bontango/BallyFa/variants/hw1_cyclone_10/variant_pkg.vhd

-- variant_pkg.vhd - was dieses Board ist, als VHDL-Konstante.
-- Variante: hw1_cyclone_10 (BallyFA HW 1.x mit dem Cyclone 10 Board (10CL006YE144C8G))
--
-- Diese Datei liegt im Variantenordner, nicht in rtl/common/, und ist der ERSTE
-- Eintrag der erzeugten .qsf. Alles uebrige am Design ist gemeinsam.
library ieee;
use ieee.std_logic_1164.all;

package variant_pkg is
	-- Ziffer des FPGA-Boards in der Boot-Anzeige ([HW] BOARD_ID . SW_SUB1 SW_SUB2,
	-- siehe rtl/common/version_pkg.vhd): 1 Cyclone II, 2 Cyclone IV, 3 Cyclone IV v4.x, 4 Cyclone 10.
	-- Dieselbe Ziffer steht im Releasenamen BallyFA_4xx.jic.
	constant BOARD_ID : std_logic_vector(3 downto 0) := x"4";

	-- Game ROMs from the configuration flash when no SD card answers (rtl/common/Flash_ROM.vhd).
	constant HAS_FLASH_ROM : boolean := true;
end package variant_pkg;
