bontango/BallyFa/(commit log)

2021-12-23 Update pia6821.vhd
    fixed bug in IRQA(B) flag reset
    [pia6821.vhd]
2026-10-21 BallyFA: gemeinsamer Sourcebaum fuer alle 8 Varianten
    Acht flache Quartus-Ordner (4 FPGA-Boards x Basisplatine HW 1.x/2.x), keiner
    unter Git, zu einem Baum zusammengelegt. Die Historie beginnt hier; die alten
    Ordner liegen als Backup daneben und als ZIP unter ..\Archive\.
    - top/Bally_core.vhd: gemeinsamer Kern, Eingaenge in HW-1.x-Polaritaet
    - top/BallyFA_HW1.vhd / BallyFA_HW2.vhd: Platinenhuellen; HW2 invertiert die
    sechs 4049-Eingaenge und enthaelt lisy_api (USB)
    - rtl/common, rtl/cyclone_{ii,iv,10}, rom/elektra.hex (init_file jetzt explizit)
    - variants/<n>: pins/device/variant_pkg, .qsf generiert von scripts/gen_qsf.ps1
    - scripts: check/build/release mit Quartus 13.0sp1 (Cyclone II) bz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
2026-10-21 Bally.sdc: Hold-Verstoss clk_50 -> clk_out behoben (Cyclone II)
    Cyclone II verletzte Hold auf clk_out (Slow -1.665/-1.829 ns, Fast -0.977 ns,
    Removal -0.068 ns; Critical Warning 332148). clk_out ist ein Ripple-Takt aus
    cpu_clk_gen, dessen Taktbaum ~2.6 ns hinter clk_50 liegt. Alle verletzten
    Pfade gehen clk_50 -> clk_out (RAM/ROM -> cpu68, DIP-Anzeige -> boot_message,
    cpu_reset_h -> Reset); an der mit clk_out zusammenfallenden clk_50-Flanke
    aendern sich deren Daten nicht.
    - set_multicycle_path -hold -start 1 clk_50 -> clk_out (Hold -20 ns, Setup 20 ns)
    - clk_out mit -edges {1 103 203} statt -divide_by 100: der Zaehler teilt
    durch 101 (51 high / 50 low), die fallende Flanke lag 10 ns daneb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
2026-10-21 Kern mit HW_GEN, vier Platinenhuellen, FLASH-Pins (Vorbereitung x.30)
    Die Unterschiede HW 1.x / HW 2.x (4049-Inversion, lisy_api, LED_1/LED_2)
    liegen jetzt im Kern (Generic HW_GEN, paarweise generate). Die Huellen
    deklarieren nur noch Ports:
    BallyFA_HW1 / BallyFA_HW2 Cyclone IV/10, mit FLASH_DCLK/NCS/ASDO/DATA0
    BallyFA_HW1_cii / BallyFA_HW2_cii Cyclone II, ohne (keine User-I/O dafuer)
    Generic HAS_FLASH_ROM (variant_pkg) ist ueberall noch false, die Flash-Pins
    sind konstant (nCS high). Pins wie WillFA7, RESERVE_DATA0/DATA1/FLASH_NCE/DCLK
    als Regular IO (ohne DATA1 belegt der Fitter Pin 6 mit ASDO_DATA1, 176310).
    Abnahme: HW 1.x Comb/Reg/Mem exakt gleich. HW 2.x Comb -2..+4, Reg/M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
2026-10-21 Flash-Fallback: Spiel-ROMs aus dem Konfigurationsflash (Cyclone IV/10)
    Nach WillFA7 HAS_FLASH_ROM. Antwortet keine SD-Karte (SD_Card v05,
    neuer Ausgang o_no_card), liest rtl/common/Flash_ROM.vhd denselben 8-KByte-
    Slot aus dem EPCS16 (080000h + n*2000h, Slots 0..191) und uebernimmt
    ROM-Schreibport, CPU-Reset und SD-LED. Leerer Slot (Reset-Vektor 1FFEh = FFFF)
    oder Slot >= 192: Fehler 8 (Blinkcode), CPU startet nicht. Beim Flash-Boot
    zeigt Display 4 die Slotnummer, bei Fehler 8 mit einer 8 vorn.
    HAS_FLASH_ROM = true auf den 6 Cyclone-IV/10-Varianten; Cyclone II unveraendert
    (Zahlen exakt gleich). Cyclone IV/10: ~+320 Comb, +122 Reg, Timing erfuellt,
    FLASH_* laut Pin-Report auf den Konfigurat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
2026-10-21 Release x.30: Spiel-ROMs aus dem Konfigurationsflash
    - version_pkg: SW_SUB 3/0 -> Anzeige 1.30 ... 4.30 bzw. 2 1.30 ... 2 4.30
    - scripts/make_flash_hex.ps1: SD-Kartenimage (Slot n ab Sektor 660 + n*16)
    -> Intel-HEX fuer den EPCS16 ab 080000h, Slots 0..191, leere Slots aus
    - variants/<Cyclone IV/10>/bally_roms.cof: Bitstream + Hex-Block -> bally_roms.jic
    - build.ps1 -RomImage / release.ps1 -RomImage: lokale *_roms.jic, Kontrolle
    in der .map (Page_0 ab 0, ROM-Block ab 080000h); *_roms.* gitignored
    - bin/HW_v1.x, bin/HW_v2.x: BallyFA_[2_]<B>30.pof/.jic, ROM-frei (geprueft per
    Mustersuche), Changelog mit SHA256
    - README, WORKFLOW: Flash-Fallback, vier Huellen, ROM-Workflow
    Alle x.30-Binar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
2026-10-21 make_flash_hex: nur die Spiele bis zur Image-Kennung in den Flash
    _make_SD.bat schreibt hinter das letzte Spiel die Kennung "this is SD image
    v<nnn>" (Image 111: 142 Spiele, Kennung in Slot 142); dahinter liegen alte
    Sektorinhalte der Karte. Bisher wurden die Slots bis 191 komplett uebernommen,
    also auch diese Reste. Jetzt endet das Skript an der Kennung (oder nach
    -Games), Slots dahinter bleiben im Flash leer -> Fehler 8 statt Altdaten.
2026-10-21 bin/ nach FPGA-Board geordnet, wie WillFA7
    bin/Cyclone_II/ BallyFA_1xx.pof, BallyFA_2_1xx.pof
    bin/Cyclone_IV/FPGA_board_v3.x/ ..._2xx.jic (EP4CE6F17)
    bin/Cyclone_IV/FPGA_board_v4.x/ ..._3xx.jic (EP4CE6E22)
    bin/cyclone_10/ ..._4xx.jic
    statt bin/HW_v1.x und bin/HW_v2.x. Die Basisplatine steht weiter im Namen
    (BallyFA_2_... = HW 2.x). Dateien per git mv verschoben (Historie bleibt),
    BinFolder in variant.psd1 umgestellt, Pfade in README, release.ps1,
    baseline.csv und den x.30-Zeilen von Changelog.txt nachgezogen.
2026-10-21 bin/ nach Basisplatine und FPGA-Board, wie lisy.dev/swrep/BallyFA/software/
    bin/hardware_v1.x/Cyclone_II/
    bin/hardware_v1.x/Cyclone_IV/FPGA_board_v3.x/ (EP4CE6F17)
    bin/hardware_v1.x/Cyclone_IV/FPGA_board_v4.x/ (EP4CE6E22)
    bin/hardware_v1.x/Cyclone_10/
    bin/hardware_v2.x/... dieselben Ordner
    bin/Changelog.txt
    Dateien per git mv verschoben, Namen unveraendert. BinFolder in variant.psd1,
    Pfade in README, release.ps1, baseline.csv und Changelog.txt nachgezogen.
2026-10-21 U2andU6 ohne Vorbelegung, rom/elektra.hex entfernt
    rom/elektra.hex war die Init-Datei von U2andU6 - ein Spiel-ROM, das nicht im
    oeffentlichen Repo liegen soll. U2andU6 hat jetzt init_file = UNUSED (alle drei
    Familien); beim Start laedt SD_Card bzw. Flash_ROM das Spiel ohnehin.
    x.30 mit gleicher Versionsnummer neu gebaut (release.ps1 -Force): Comb/Reg/Mem,
    LE und Slack aller 8 Varianten unveraendert, nur der Speicherinhalt; in keinem
    Report steht mehr eine Init-Datei. Changelog: die x.30-Eintraege zusammengefasst
    (neue Pruefsummen).
    Die alten Releases bis x.23 enthalten die Vorbelegung weiterhin im Bitstream;
    die Datei bleibt ausserdem in der Git-Historie (bewusst, kein Force-Push).
    Co-Aut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
2026-10-23 Handbuch als HTML: docs/BallyFA_user_manual.html, Stand x.30
    Aus BallyFA_user manual_v1.23.docx neu aufgesetzt und auf x.30 gebracht:
    Versionsanzeige [2] Board.30 und Board-Tabelle, Dip2 sekuendlich speichern
    (seit x.23), Flash-Rueckfall ohne SD-Karte (Display 4, Fehler 8), USB bei
    HW 2.x, Spieleliste des Images v111 (142 Spiele), Versionsgeschichte.
    Eine Datei, ohne externe Abhaengigkeiten.
2026-10-23 Handbuch auf Deutsch und Franzoesisch, README auf Englisch
    BallyFA_Bedienungsanleitung.html und BallyFA_manuel_utilisateur.html aus dem englischen Handbuch uebersetzt; Anhang A (Spieltabelle) und Anhang B (ROM-Beschreibung) unveraendert uebernommen. Alle drei Fassungen verweisen aufeinander, index.html listet sie. README.md komplett ins Englische uebertragen, Abschnitt User manuals mit allen drei Sprachen.
2026-10-23 index.html aus den Handbuechern erzeugt, Beschreibung je Handbuch
    Every manual carries <meta name=description> now; make_index.ps1 builds the landing page from the manuals in docs/ (title, language, description).
